lwa231/MakeUC_2026/HANDOFF_LIVE_DEMO.md

# Handoff: live demo wiring (accelerometer stream -> 3D viewer), MakeUC 2026 Brace Tracker

*Snapshot: 2026-11-07, late evening. Continues `HANDOFF_ARDUINO.md` (Arduino/bridge/camera details, in the parent folder `MakeUC2026/`; read it for hardware facts). Items are labeled DONE / VERIFIED / OPEN / NOT TESTED.*

Repo: https://github.com/lwa231/MakeUC_2026, cloned to `MakeUC2026/repo/`. Python 3.12.9 (python.org), macOS on Apple Silicon.

---

## 1. Goal and the one rule

Connect the Arduino accelerometer stream (Python side, `serial_bridge.py`) to the C++ OpenGL 3D viewer (`main.cpp`) using their existing variables and code. **Do not edit `main.cpp`, `fake_pi.py`, `serial_bridge.py` or `camera_origin.py`**; glue goes in `live/` as new scripts. Ask the user before breaking this rule. (Their reasoning: the existing code already works; only connect it.)

*Update (sensor-smoothing branch):* `fake_pi.py` is deleted (`live/mock_sensors.py` replaces it) and `main.cpp` now also reads `K`/`M` lines from `leg_filter.py` (smooth playout, keys `C [ ] ; ' V Z`); its old 7-field path still works.

They were already compatible at the data level: the bridge prints `t_ms,thigh_x,thigh_y,thigh_z,shank_x,shank_y,shank_z[,4 position cols]` to stdout and `main.cpp` popen()s any `--pi-cmd` command and `sscanf`s the first 7 fields (extra fields and non-sample lines are ignored). What was missing was a way to build and launch them together on a Mac.

## 2. Data flow (as launched)

```
Arduino (MMA7660 x2) --USB 115200--> serial_bridge.py --stdout--> live/leg_filter.py --K/M lines--> build/viewer (main.cpp via popen --pi-cmd)
  (--demo: live/mock_sensors.py, which also writes the camera file)      ^  knee_estimator.py (Kalman filter: accel + late camera frames)
                                                                         |  calibrate.py (Hang and Straighten, Anchor, Bench check)
  build/leg_state.json{,.cam,.tune} <-- live/leg_panel.py (leg switch, webcam/ArUco, Fusion card; Tk)
  build/leg_state.json.viewer <-- viewer keys;  build/leg_state.json.stats <-- leg_filter (2 Hz, read by the panel)
```

`live/run_live.py` assembles and launches all of it.

## 3. Files (all new, under `repo/` unless noted)

| File | Purpose | Status |
|---|---|---|
| `serial_bridge.py`, `camera_origin.py`, `brace_sensors_3.ino` | Copied unchanged from `MakeUC2026/` into the repo root | DONE (untracked in git) |
| `live/build_viewer.sh` | Builds `main.cpp` -> `build/viewer`. Installs `glfw`/`glm` via brew if missing; generates glad v1 (GL 3.3 core) with `glad==0.1.36` in a throwaway venv `build/glad-venv` (needs internet on first run; sets `SSL_CERT_FILE` via certifi); creates an include shim so `#include <GLFW/include/GLFW/glfw3.h>` resolves without editing main.cpp | VERIFIED: zero warnings, GL 4.1 Metal context |
| `live/third_party/glad`, `live/third_party/shim` | Generated by the script. Not in `.gitignore` (add `live/third_party/` or commit) | DONE |
| `live/run_live.py` | The launcher (stdlib only). See section 4 | VERIFIED |
| `live/leg_filter.py` | Between source and viewer: bench correction, leg mapping (calibration sign, or invert/rot180), `knee_estimator.KneeFilter` fused with the camera, runs calibrations, writes `K`/`M` lines, heartbeat, `.stats`; SIGINTs the bridge on exit | VERIFIED with the mock (K lines at ~100 Hz track truth; calibration runs from `.tune`) |
| `live/knee_estimator.py`, `live/calibrate.py`, `live/mock_sensors.py` | Kalman fusion + One Euro display filter; calibration procedures; simulated brace + camera | VERIFIED offline |
| `live/leg_panel.py` | Tk window: LEFT/RIGHT, webcam with ArUco overlay, **Fusion card** (camera share, responsiveness, source, Calibrate / Anchor / Bench check / Zero, calibration status); writes `build/leg_state.json` and `.tune`, publishes the camera angle with `t_cap`/`seq` | UI builds with `--no-camera`; **never used with the real board/webcam** |
| `live/sensor_check.py` | Sends `C` to the Arduino and prints its self-check (`# thigh ... ok/FAIL`) | VERIFIED |
| `live/sim_arduino.py` | Fake Arduino on a pty, same protocol/format as the firmware (S/X/C/I commands, 100 Hz, MMA7660 quantization) | VERIFIED |
| `live/verify_pipeline.py` | Runs bridge against the simulator and checks format, rate, S/X handling, popen-style shutdown. 45 checks | PASS 45/45 (one run had 4 timing-artifact failures from stale sim backlog; reruns pass) |
| `live/README_LIVE.md` | Cheat sheet: commands, keys, Fusion card, calibration procedure | UPDATED |
| `requirements.txt` | `pyserial>=3.5`; `opencv-contrib-python` commented (camera only) | DONE |

## 4. How to run

```bash
cd /Users/luqman_ahmed/Desktop/MakeUC2026/repo
python3 live/run_live.py --pretty-check      # data only, no window; expect ~100 Hz
python3 live/run_live.py                     # opens the LEFT/RIGHT window, then the viewer
python3 live/run_live.py --leg right         # skip the choice
python3 live/run_live.py --demo              # mock brace + camera (live/mock_sensors.py), no hardware
python3 live/sensor_check.py                 # Arduino's own sensor self-check
python3 live/verify_pipeline.py --skip-silent   # no-hardware regression test
bash live/build_viewer.sh                    # rebuild the viewer (needed after any main.cpp edit)
```

Other `run_live.py` flags: `--port P`, `--camera [N]`, `--no-position`, `--log f.csv`, `--viewer-args "..."`, `--bridge-args "..."`, `--kill-stale`, `--dry-run`, `--no-panel`, `--no-install`. Exit code 3 = serial port busy (it names the holder; usually the Arduino IDE Serial Monitor). Viewer keys: C calibrate, Z quick zero (only if truly straight), `[ ]` camera weight, `; '` responsiveness, V source (fused / sensors / camera), SPACE toggle auto demo, R reset, LEFT/RIGHT orbit, ESC quit. Calibrate each session: sit, press C, let the shin hang, straighten and hold, hang again (~35 s); see `live/README_LIVE.md`. `--demo --scenario calib` plays a calibration session (press C at the start).

## 5. Left/right leg (latest change)

User report: on the **left** leg the model is right side up; on the **right** leg it is upside down ("shin where the thigh should be and vice versa").

`main.cpp` shows only the knee angle `wrapDeg(kKneeSign * (tilt(shank) - tilt(thigh)) - zeroOffset)`, clamped to 0..120 for display, with `tilt = atan2(sag, vert)`, `kSagAxis=0 (x)`, `kVertAxis=2 (z)`. Axis map is compile-time.

Resolved: the knee angle now comes from `live/leg_filter.py` (bend plane = each board's x-y, z = hinge
axis), and **calibration (C) finds the bend direction and any upside-down sensor itself**. `invert` /
`rot180` in `build/leg_state.json` are only per-leg defaults for the display before calibrating (right leg:
invert ON); the panel no longer has chips for them or for mirroring the camera.
- `--demo` defaults to the left leg (the mock is a left leg); with `--leg right` it reads inverted until calibrated. A completed calibration replaces invert/rot180 (it finds the bend sign itself).

## 6. State at the end of this session

- VERIFIED earlier on the real board: `--pretty-check` read ~103 Hz (309 samples / 3 s), |a| ≈ 1 g both sensors; real viewer ran (window `LIVE`, left leg looked right side up per the user).
- At one point the Arduino reported both sensors "FAIL, no answer at 0x4C" (loose Grove cable/power); the user reseated them and data returned. If `run_live.py` says "NO DATA" while the log says "arduino: streaming", run `live/sensor_check.py`.
- A demo run (`python3 live/run_live.py`) was started in the background and was waiting at the leg chooser window; kill leftovers with `pkill -f run_live.py` (the launcher also reaps bridge/filter/panel children).
- Hardware port on this Mac: `/dev/cu.usbmodem11401` (the earlier handoff says `usbmodem1401`; auto-detect handles both). Only one program may open the port.

## 7. OPEN items

1. **Verify the right-leg fix on a real right leg** (section 5); adjust defaults in `live/leg_panel.py` (`DEFAULTS`) if the other combination is right.
2. **Not visually verified in automated testing:** the 3D leg rendering (no screenshot permission); only window titles via a throwaway `DYLD_INSERT_LIBRARIES` hook (title `Brace Tracker | knee X deg | LIVE q=0.95 | ...`).
3. **Planned UI, not built (user said "take note"):** Start button, Stop button, rep counter, other stats. Agreed design (HANDOFF_ARDUINO.md §7.4): Arduino streams continuously; Start/Stop controls *recording* on the laptop; rep counting = hysteresis state machine on the knee angle. `main.cpp` has no text/button drawing (title bar only), so this means either a Tk panel (like `leg_panel.py`) reading the same stream, or editing `main.cpp` (ask first).
4. **Axis map on the actual leg** (`kSagAxis/kVertAxis/signs` in `main.cpp`): bench readings showed thigh gravity mostly on x and shank on y, i.e. the map may not match how the sensors are strapped; the user's left leg looked correct as-is, so it works for that mounting.
5. Add `live/third_party/` and `build/` handling to `.gitignore`; commit nothing has been committed or pushed (all new files are untracked).
6. **Known limitations:** resolution is 0.047 g/count (~2.7 deg tilt steps), no gyro, keep exercise slow; do not press Z across a bridge reconnect (t_ms restarts; zeroing runs long); a truncated last field is not detected (no checksum); SIGTERM/SIGHUP on the bridge skip the `X` stop command (harmless); `--camera` never run on a real webcam; Windows untested for the new scripts (`leg_filter.py` uses `select` on a pipe, which does not work on Windows; the viewer/popen path itself is cross-platform).
7. Camera/ArUco (3 markers: knee ID 1, thigh-arm end ID 0, shank-arm end ID 2, PNGs in `MakeUC2026/markers/`) and sensor-position columns are built but unverified on hardware; the viewer ignores the position columns.

## 8. Language rule (unchanged)

Report ROM against a user/clinician-set target. Never claim "healed", "recovered", or a diagnosis. Prototype, no clinical validation.
