lwa231/MakeUC_2026/aruco_tags_44mm.pdf

## ArUco tags (DICT_4X4_50), cut-out size 44 mm, black square 33.0 mm

Print at 100% / Actual size (NOT “Fit to page”). Check the 100 mm bar below with a ruler before cutting.

Cut on the grey lines. In the software, set the marker size to 33.0 mm (the black square).

ID 1 · KNEE | ID 0 · HIP | ID 2 · ANKLE
ID 1 · KNEE | ID 0 · HIP | ID 2 · ANKLE

Second row = spares.

0 | 50 | 100 mm

Measure this bar with a ruler: it must be exactly 100 mm.

33.0 mm check square
