lwa231/MakeUC_2026/hardware/brace/out/right_shin.step

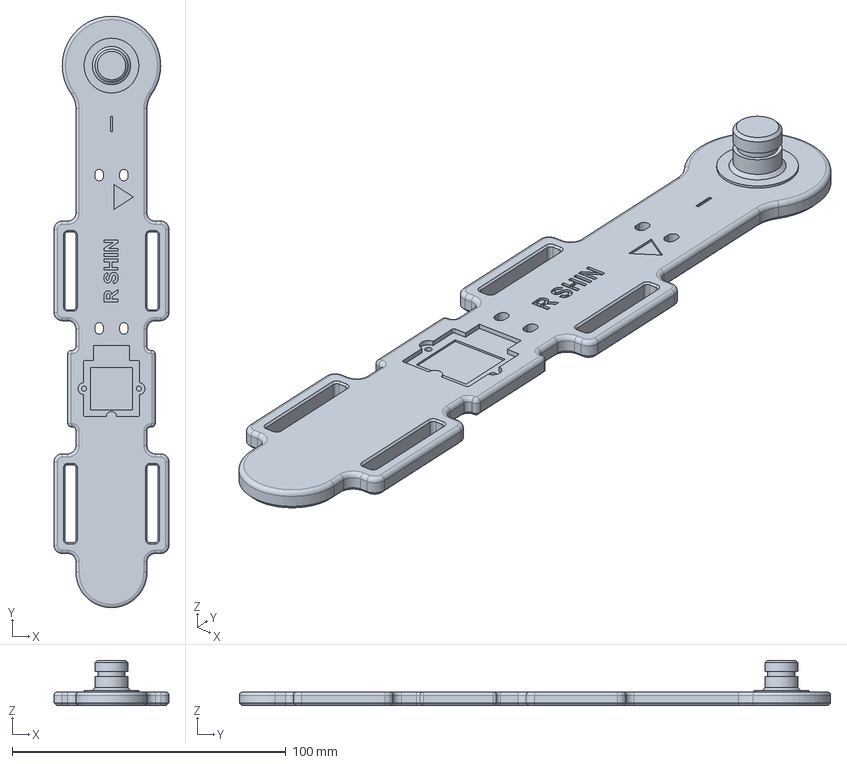
[picture p1: CAD file, 2026-11-08]
hardware/brace/out/right_shin.step
42.0 x 216.0 x 16.6 mm
