lwa231/MakeUC_2026/hardware/brace/out/knee_marker_cap.step

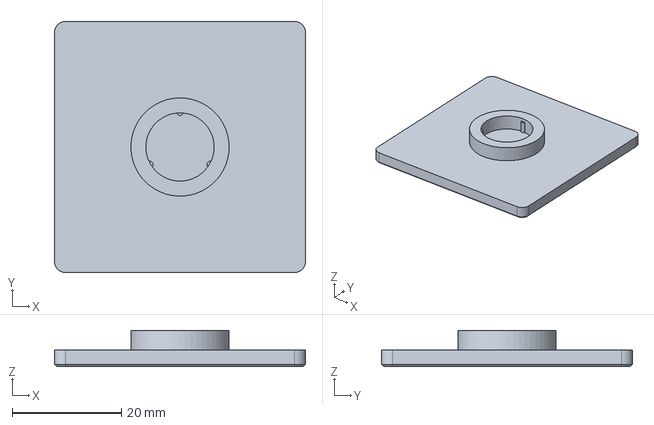
[picture p2: CAD file, 2026-11-08]
hardware/brace/out/knee_marker_cap.step
46.0 x 46.0 x 6.60 mm
