lwa231/MakeUC_2026/hardware/brace/out/axle_clip.step

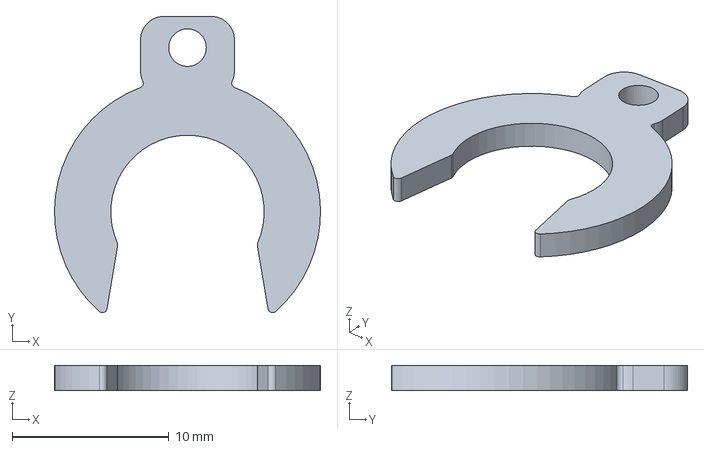
[picture p3: CAD file, 2026-11-08]
hardware/brace/out/axle_clip.step
17.0 x 18.9 x 1.60 mm
