lwa231/MakeUC_2026/hardware/brace/out/cable_clip.step

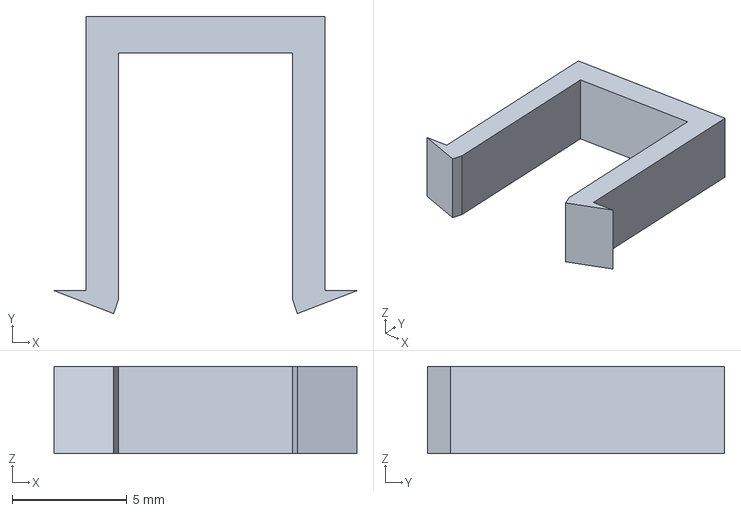
[picture p4: CAD file, 2026-11-08]
hardware/brace/out/cable_clip.step
13.2 x 12.9 x 3.80 mm
