lwa231/MakeUC_2026/hardware/brace/out/tri_glide.step

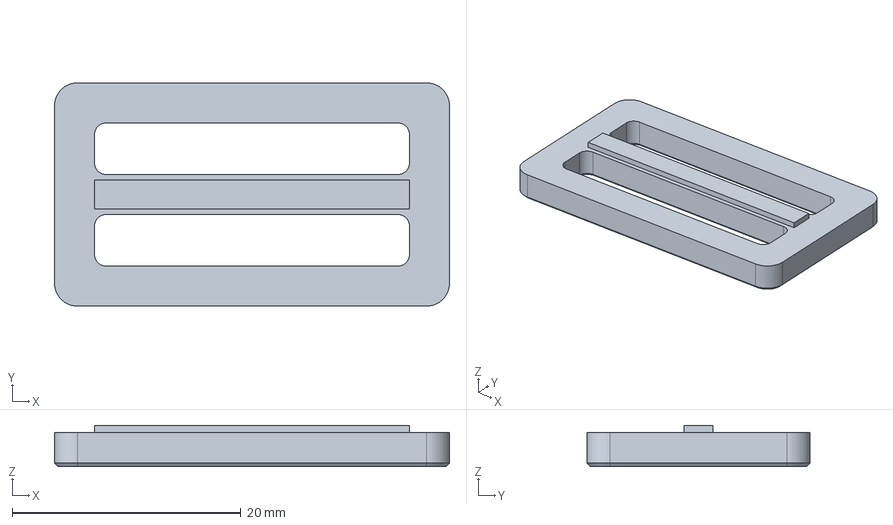
[picture p5: CAD file, 2026-11-08]
hardware/brace/out/tri_glide.step
34.5 x 19.5 x 3.60 mm
