lwa231/MakeUC_2026/hardware/brace/out/sensor_pin.step

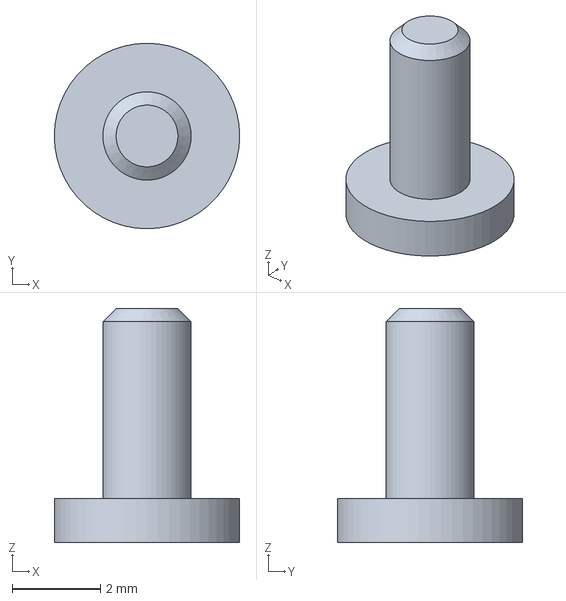
[picture p6: CAD file, 2026-11-08]
hardware/brace/out/sensor_pin.step
4.20 x 4.20 x 5.30 mm
