lwa231/MakeUC_2026/hardware/brace/out/right_thigh_nodeck.step

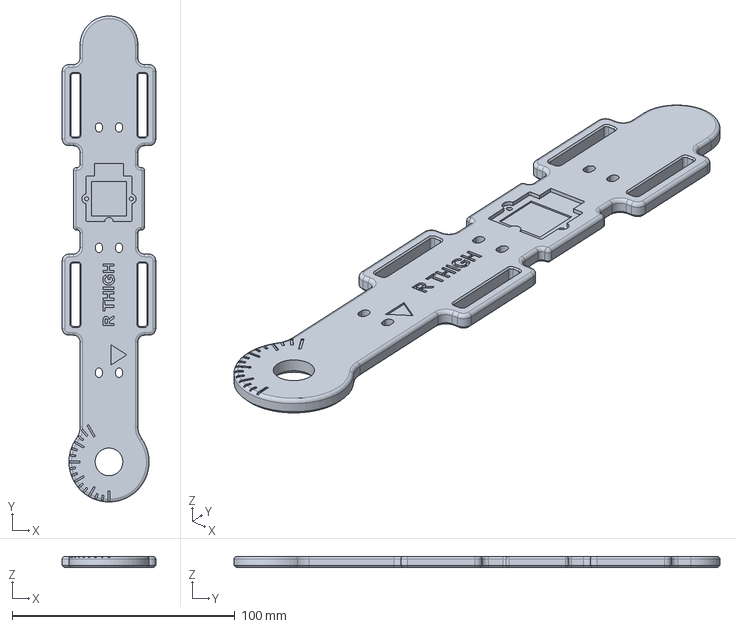
[picture p7: CAD file, 2026-11-08]
hardware/brace/out/right_thigh_nodeck.step
42.0 x 218.0 x 5.00 mm
