lwa231/MakeUC_2026/hardware/brace/out/fast_small_pla.gcode.3mf

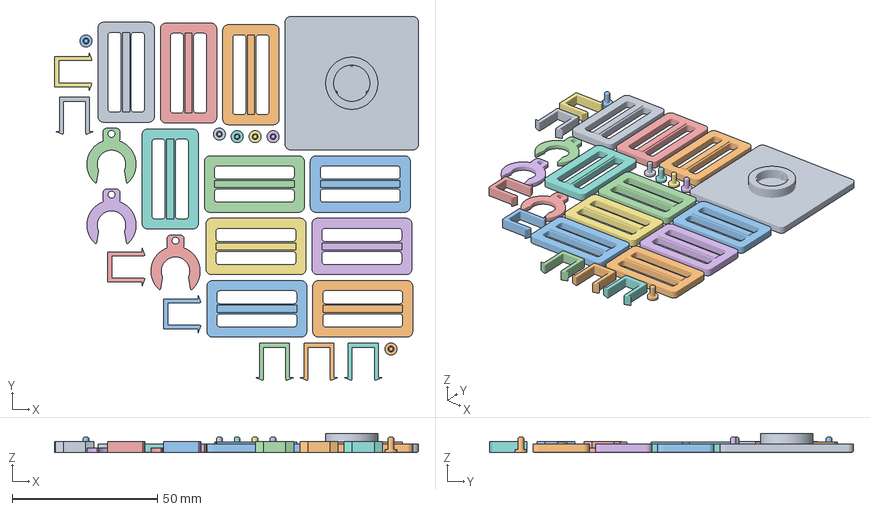
[picture p8: CAD file, 2026-11-08]
hardware/brace/out/fast_small_pla.gcode.3mf
125.4 x 125.4 x 6.60 mm
knee_marker_cap.stl
tri_glide.stl x 10
axle_clip.stl x 3
cable_clip.stl x 7
sensor_pin.stl x 6
