lwa231/MakeUC_2026/(list of files, cad)

Other CAD files:
hardware/brace/out/fast_shin_pla.gcode.3mf
hardware/brace/out/fast_thigh_nodeck_pla.gcode.3mf
