lwa231/MakeUC_2026/(commit log)

2026-11-07 Better looking leg, same everything else
2026-11-08 Replace oversized ArUco tag PDF with correctly sized sheet
    MakeUC26.pdf drew the tags at about 106 mm (79.5 mm black square), far too
    big for the 45.2 mm knee marker cap. aruco_tags_44mm.pdf has the same three
    DICT_4X4_50 tags (ID 0 hip, ID 1 knee, ID 2 ankle) with a 44 mm cut-out and a
    33.0 mm black square, plus a spare set and a 100 mm scale bar. Print at 100%
    ("Actual size") and set the software's marker size to 33.0 mm.
2026-11-08 Connect accelerometer stream to 3D viewer, add live launcher and camera assist
2026-11-08 Add 3D-printed knee brace: CAD model, STEP parts, and print files
    brace.py is the parametric CadQuery model. out/*.step are the parts as printed (right leg, thigh bar without the Pi deck). out/fast_*_pla.gcode.3mf are the sliced Bambu H2S plates that were printed.
    [axle_clip.step, cable_clip.step, fast_shin_pla.gcode.3mf, fast_small_pla.gcode.3mf, fast_thigh_nodeck_pla.gcode.3mf, knee_marker_cap.step, right_shin.step, right_thigh_nodeck.step]
2026-11-08 Smooth the live knee display, fuse camera + accelerometers, add calibration
    - knee_estimator.py: one Kalman filter [theta, omega, b] with delayed-camera
    replay, outlier gating and a One Euro output stage; weight slider w sets the
    camera's share of trust (0 = sensors only, 1 = camera only)
    - leg_filter.py: I/O shell emitting timestamped K lines plus M messages;
    reads panel/viewer settings, runs calibration, saves it per leg
    - calibrate.py: Hang and Straighten (with strap-slip re-check), Anchor mode
    for limited flexion, and a once-per-brace Bench check
    - main.cpp: timestamped playout with Hermite interpolation (no judder),
    keys [ ] ; ' V Z C, calibration status in the title
    - leg_pan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
    [calibrate.py, eval_fusion.py, knee_estimator.py, leg_filter.py, leg_panel.py, main.cpp, mock_sensors.py, run_live.py]
2026-11-08 Fix accelerometer axes, make the camera lead, reject accel jolts
    - The brace boards lie flat on the bars, so the knee bends in each board's
    x-y plane (z is the hinge axis). The angle was read from x-z, which made
    the display spin and jitter. One shared tilt()/raw_knee() now uses x-y;
    calibration, the mock and the shin-flip option follow it.
    - Camera share defaults to 0.75: the camera sets the angle, the
    accelerometers fill in motion between frames and when the tags are lost.
    - Accelerometer samples far from the predicted motion are down-weighted
    (Huber) so jolts don't show up as blips.
    - watch_log.py prints the bridge's --log CSV readably at 10 Hz.
    - .gitignore: .venv/
    [calibrate.py, knee_estimator.py, leg_filter.py, main.cpp, mock_sensors.py, test_live.py, watch_log.py]
2026-11-08 Make calibration work with boards turned in their pockets, and forgiving
    - Drop the shin/thigh orientation checks: they assumed each board's x axis
    runs along the limb, but on the real brace the shin board sits ~90 deg
    turned, so the hang check always failed (read 72-74 deg). Board rotation
    cancels out of the knee offset anyway.
    - Bench check: recognise poses by how the gravity direction turns (flip /
    quarter turn) and solve offsets from all four poses, so it works however
    the boards are mounted.
    - Forgiving flow: a wobble just restarts the 2 s hold ("Hold still..."),
    30 s per step, re-hang accepted within 5 deg and both hangs averaged.
    - Test covers boards turned up to +-100 deg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
    [calibrate.py, test_live.py]
2026-11-08 Add setup, run and calibration instructions to the README
2026-11-08 Remove the invert / flip shin / mirror camera chips from the panel
    Calibration finds the bend direction and an upside-down sensor itself, and
    leg_filter works out the camera angle's direction, so the chips only added
    confusion. invert/rot180 stay as fixed per-leg defaults for the display
    before calibrating.
    [leg_panel.py]
